brantgeddes/ENEL387/Drawings/Power Electronics.png

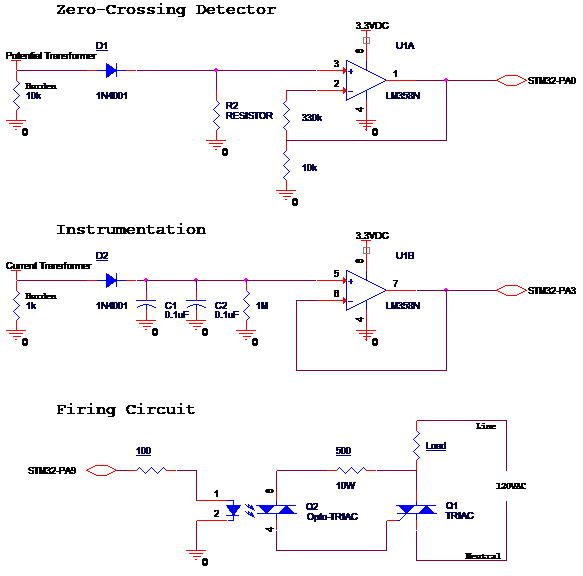
Drawings/Power Electronics.png
