brantgeddes/ENEL387/Drawings/Power Electronics.pdf

# Zero-Crossing Detector

0

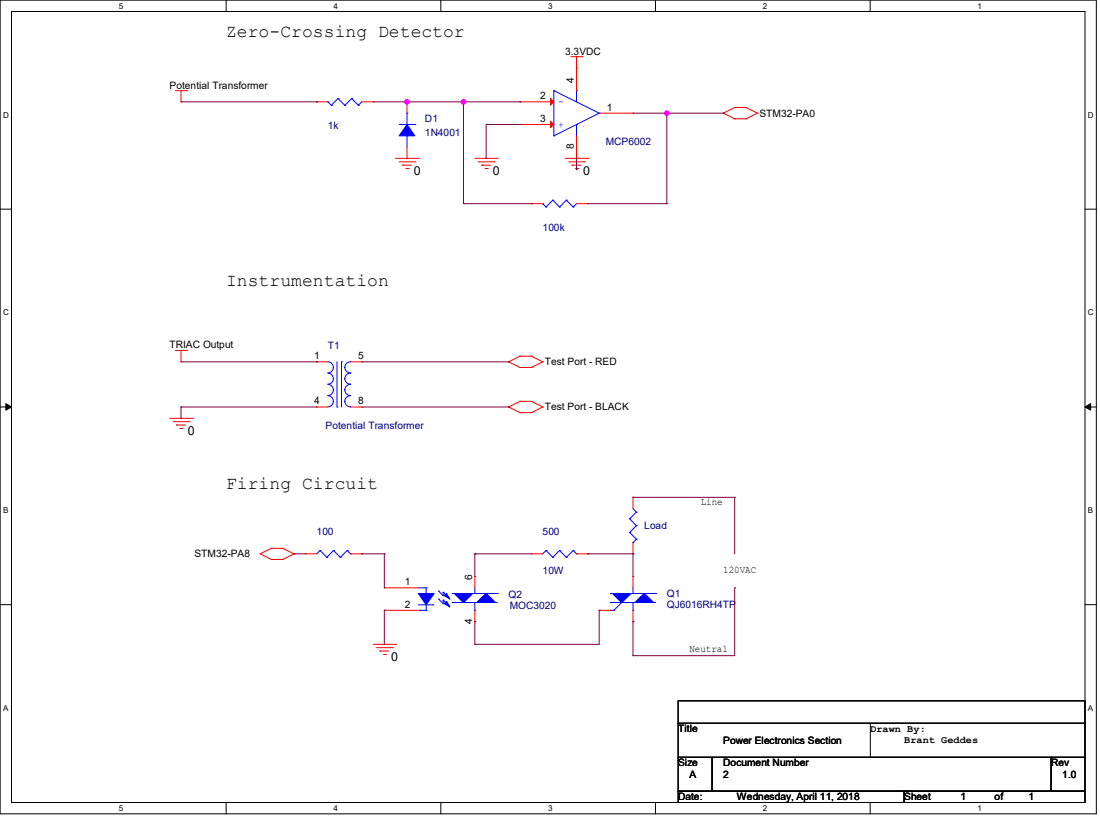
[picture p6: page 1]
120VAC; Neutral; Line; Instrumentation; Firing Circuit; Brant Geddes; Drawn By:; STM32-PA8; STM32-PA0; 3.3VDC; Potential Transformer; TRIAC Output; Title; Size; Document Number; Rev; Date:; Sheet; Wednesday, April 11, 2018; Load; Q2 MOC3020

Test Port - RED

Test Port - BLACK

Power Electronics Section
