brantgeddes/ENEL387/Drawings/Microprocessor Section.pdf

User Inputs | Setpoint Input

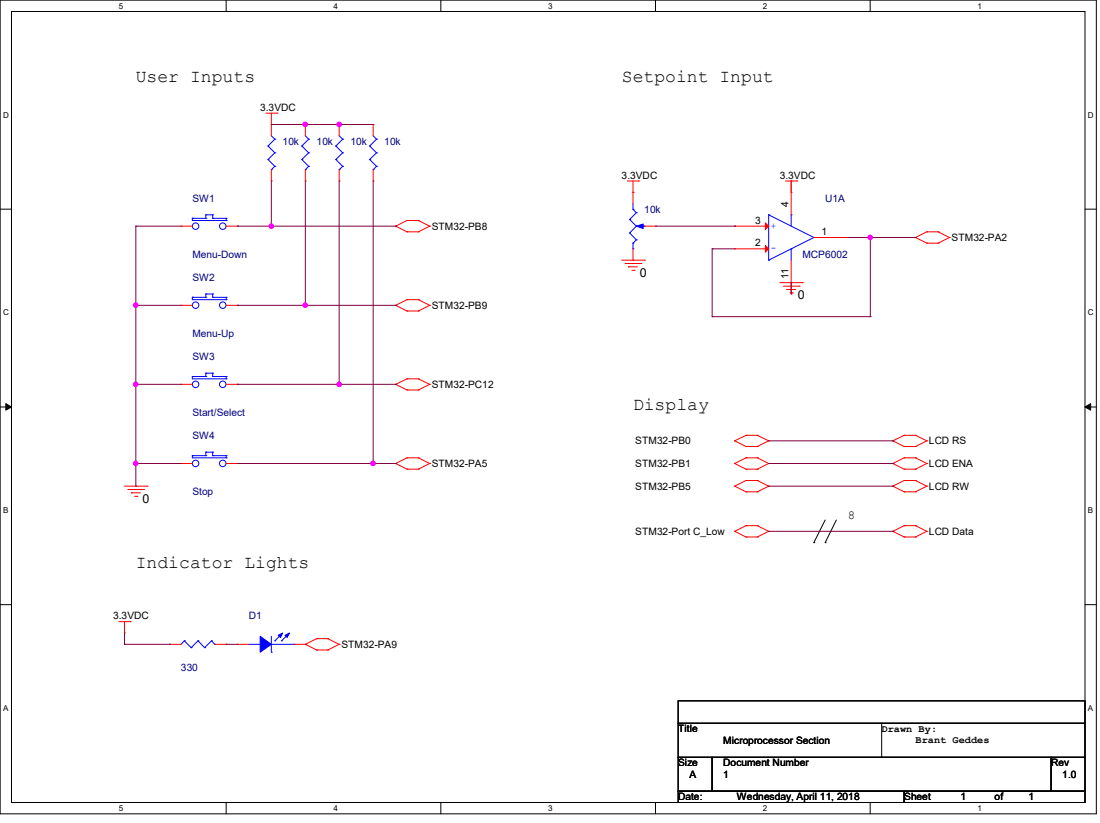
[picture p7: page 1]
Indicator Lights; Display; Drawn By: Brant Geddes; STM32-PB8; STM32-PB9; STM32-PC12; STM32-PA5; STM32-PA2; STM32-PA9; LCD RS; LCD ENA; LCD RW; LCD Data; STM32-PB0; STM32-PB1; STM32-PB5; STM32-Port C_Low; 3.3VDC; Title; Size; Document Number; Rev; Date:; Sheet; Microprocessor Section; Wednesday, April 11, 2018; Stop; Start/Select; Menu-Up; Menu-Down; MCP6002
