brantgeddes/ENEL387/(list of files, drawings)

Other design files:
Sims/387ZFC_SIM.DSN
Sims/387ZFC_Sim.opj
Sims/DESIGN1.DSN
Sims/Design1.opj
Sims/DESIGN2.DSN
Sims/Design2.opj
Sims/POWER_ELECTRONICS.DSN
Sims/power_electronics.opj
Sims/uC Section.dsn
Sims/uC Section.opj
