brantgeddes/ENEL387/Code/clock_init.h

/*
Filename:
	clock_init.h
Description:
	Contains function declarations for all clock
	initialization and general purpose functions
Author:
	Brant Geddes
	200350415
	
*/

void clock_init(void);

void delay(int);
//EOF
