brantgeddes/ENEL387/(commit log)

2018-02-28 Added new drawings
    [387ZFC_Sim.opj, DESIGN1.DSN, Design1.opj, POWER_ELECTRONICS.DSN, power_electronics.opj, uC Section.dsn, uC Section.opj]
2018-04-14 Finished Project
    [DESIGN2.DSN, Design2.opj, POWER_ELECTRONICS.DSN, power_electronics.opj, uC Section.dsn, uC Section.opj]
